Andre-WL/EEEN313-Design-Project/README.md

# EEEN313-Design-Project

This repository contains files relating to the VUW Power Electronics design project.
THe PCB directory contains schemtics and designed for a theoretically adjustable controller.
OP-AMP_Schematic contins a schematic showing the eventually working system built on breadboad that uses OP-AMP symbols instead of IC symbols.
Please read the report for more information about the project and the results.
