Andre-WL/EEEN313-Design-Project/PCB/EEEN313_BOM_WebberA.xlsx

Supplier | Part no. | Qty | Desciption
Digikey | 2223-PTN10-E05SB20-ND | 2 | 5K pot
Digikey | 2223-PTN10-E25SB20-ND | 2 | 25K pot
Digikey | 2223-PTN10-E20HB20-ND | 2 | 20K pot
Digikey | 2223-PTN10-D100HB20-ND | 2 | 100K pot
Digikey | 2223-PTN10-D11HB20-ND | 2 | 1M pot
Digikey | 296-10441-5-ND | 6 | TLE2082 dual channel OP-AMP
Digikey | LM319NNS/NOPB-ND | 2 | LM319 Dual channel comparator
Digikey | BKCT3151-2-ND | 2 | Right angle through hold female banana connector (Red)
Digikey | BKCT3151-0-ND | 2 | Right angle through hold female banana connector (Black)
Digikey | BKCT3151SP-5-ND | 2 | Right angle through hold female banana connector (Green)
Digikey | 360-3762-ND | 2 | Toggle switch
Digikey | 36-81-6-ND | 2 | 9V Battery connector
Digikey | LP2950CZ-5.0/NOPB-ND | 2 | LP2950 linear regulator
