Andre-WL/EEEN313-Design-Project/(commit log)

2022-10-04 Adding PCB files
    [Buck_converter_controller.kicad_pcb, Buck_converter_controller.sch]
2022-10-14 Adding report and schematic of working system
    [Working_system_schematic.sch]
